matthewrylander/ECE445WasteBinMonitor/Notebooks/Matthew Rylander - mjr7/Pictures/IMG_6164.jpg

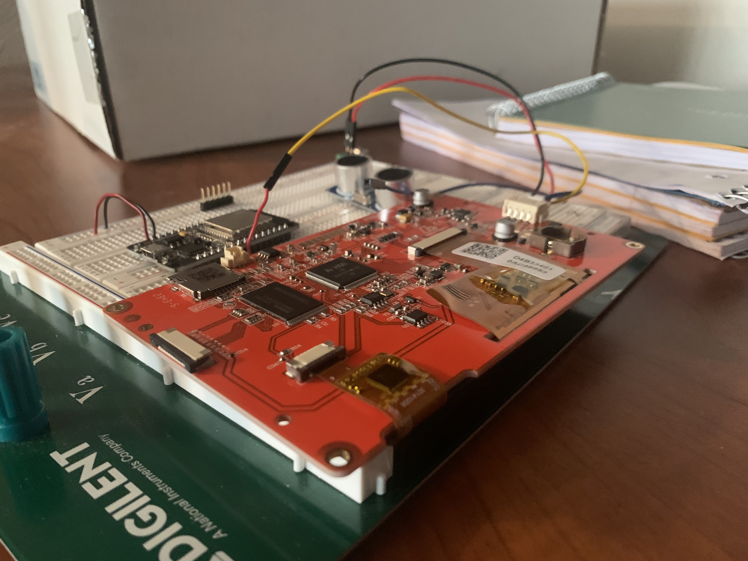
Notebooks/Matthew Rylander - mjr7/Pictures/IMG_6164.jpg
