matthewrylander/ECE445WasteBinMonitor/Notebooks/Matthew Rylander - mjr7/Pictures/IMG_6198.jpg

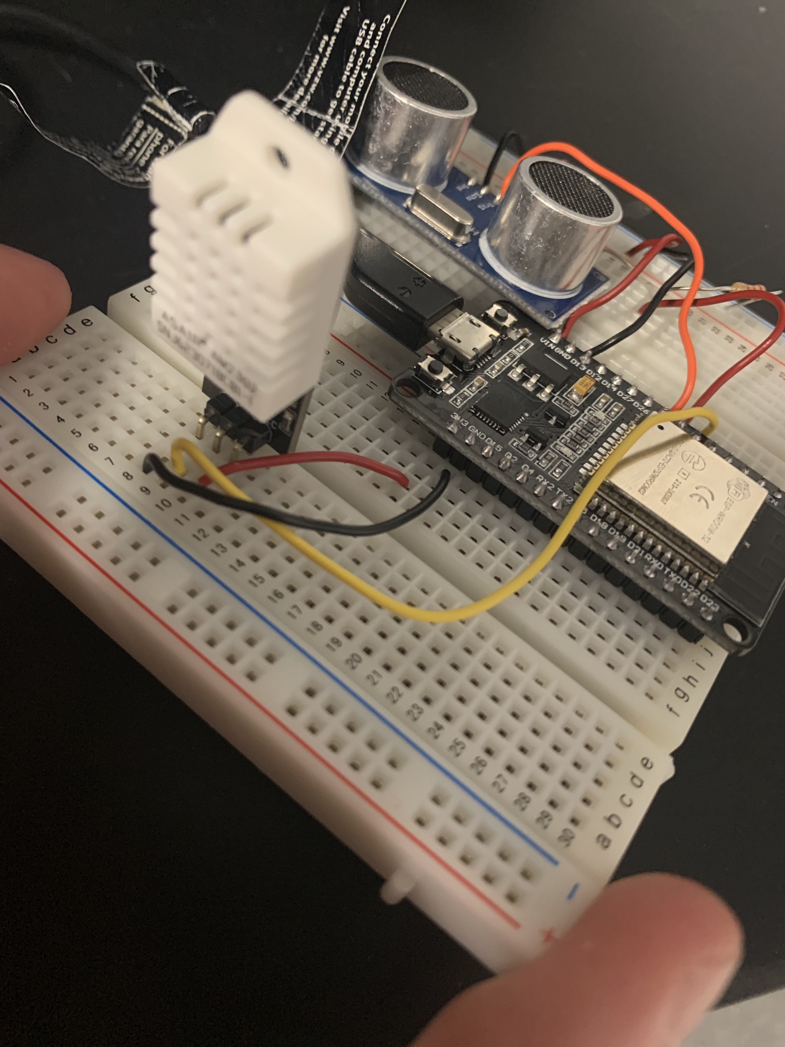
Notebooks/Matthew Rylander - mjr7/Pictures/IMG_6198.jpg
