matthewrylander/ECE445WasteBinMonitor/Notebooks/Matthew Rylander - mjr7/Pictures/IMG_6201.jpg

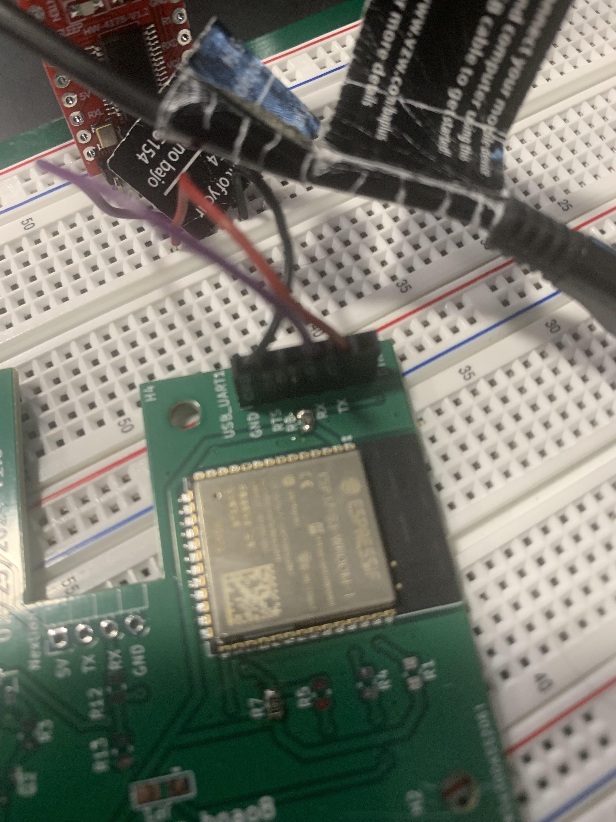
Notebooks/Matthew Rylander - mjr7/Pictures/IMG_6201.jpg
