matthewrylander/ECE445WasteBinMonitor/Notebooks/Matthew Rylander - mjr7/Pictures/IMG_6240.JPG

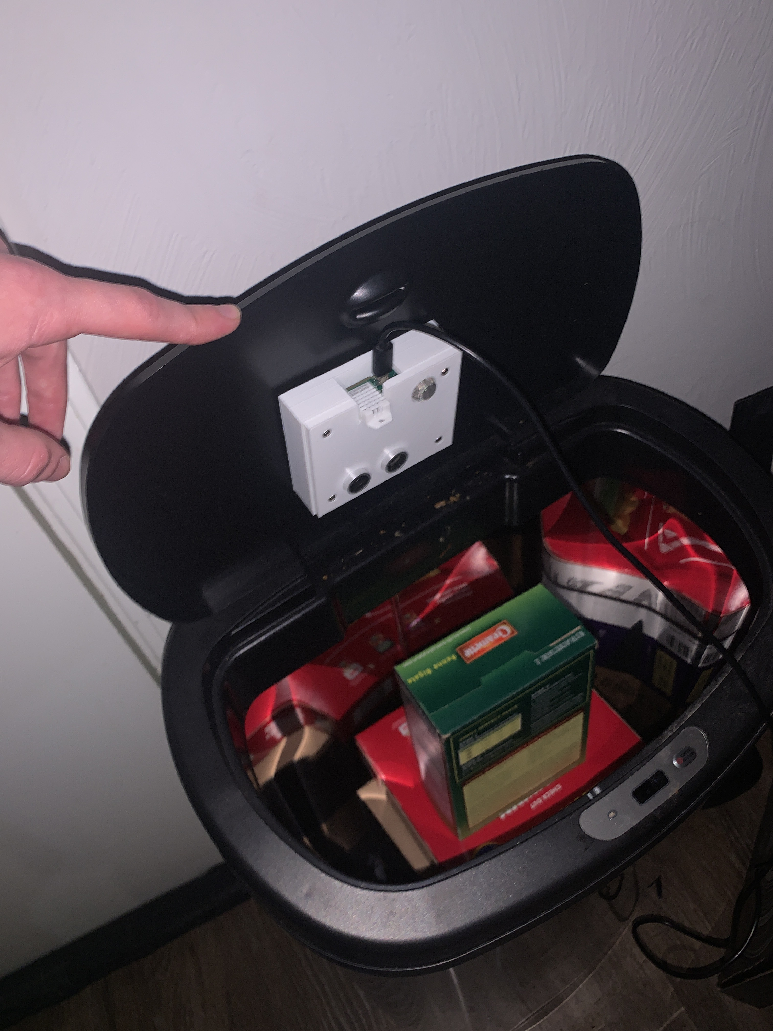
Notebooks/Matthew Rylander - mjr7/Pictures/IMG_6240.JPG
