matthewrylander/ECE445WasteBinMonitor/Notebooks/Matthew Rylander - mjr7/Pictures/Screen_software_UI.jpg

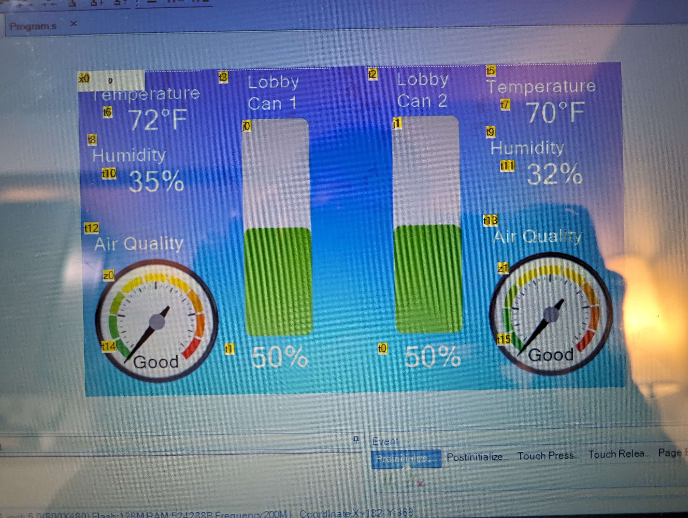
Notebooks/Matthew Rylander - mjr7/Pictures/Screen_software_UI.jpg
