matthewrylander/ECE445WasteBinMonitor/Notebooks/Matthew Rylander - mjr7/Pictures/Sensor_mounted.jpg

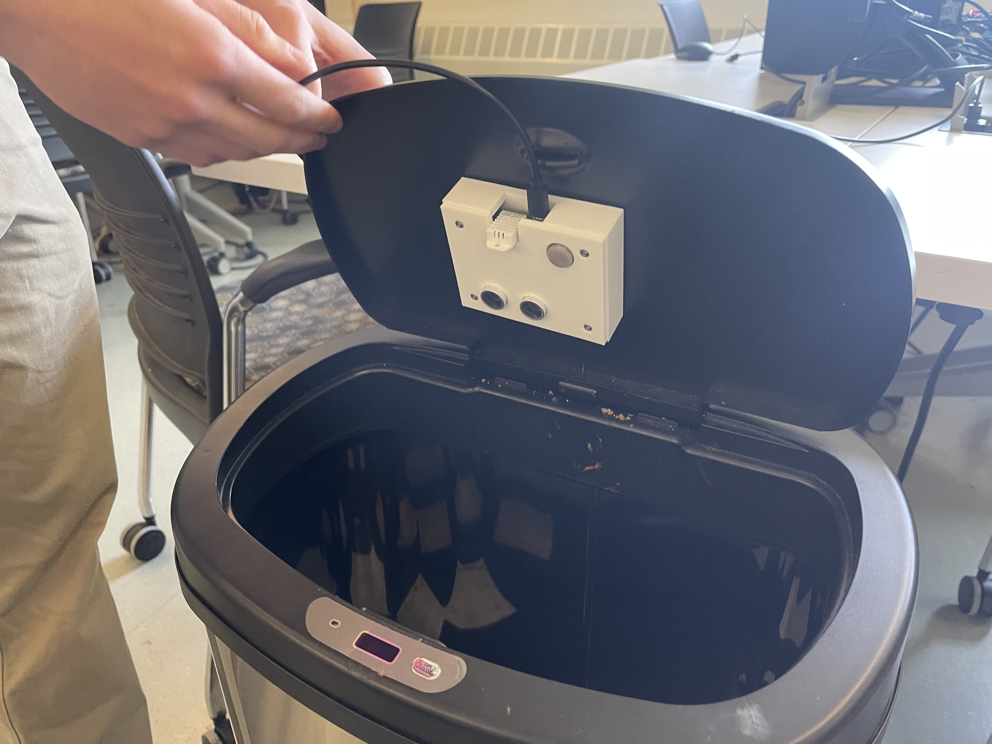
Notebooks/Matthew Rylander - mjr7/Pictures/Sensor_mounted.jpg
