matthewrylander/ECE445WasteBinMonitor/Hub Board/ESP32.kicad_pcb

## KiCad design Hub Board/ESP32.kicad_pcb (2024-03-01, an earlier design)

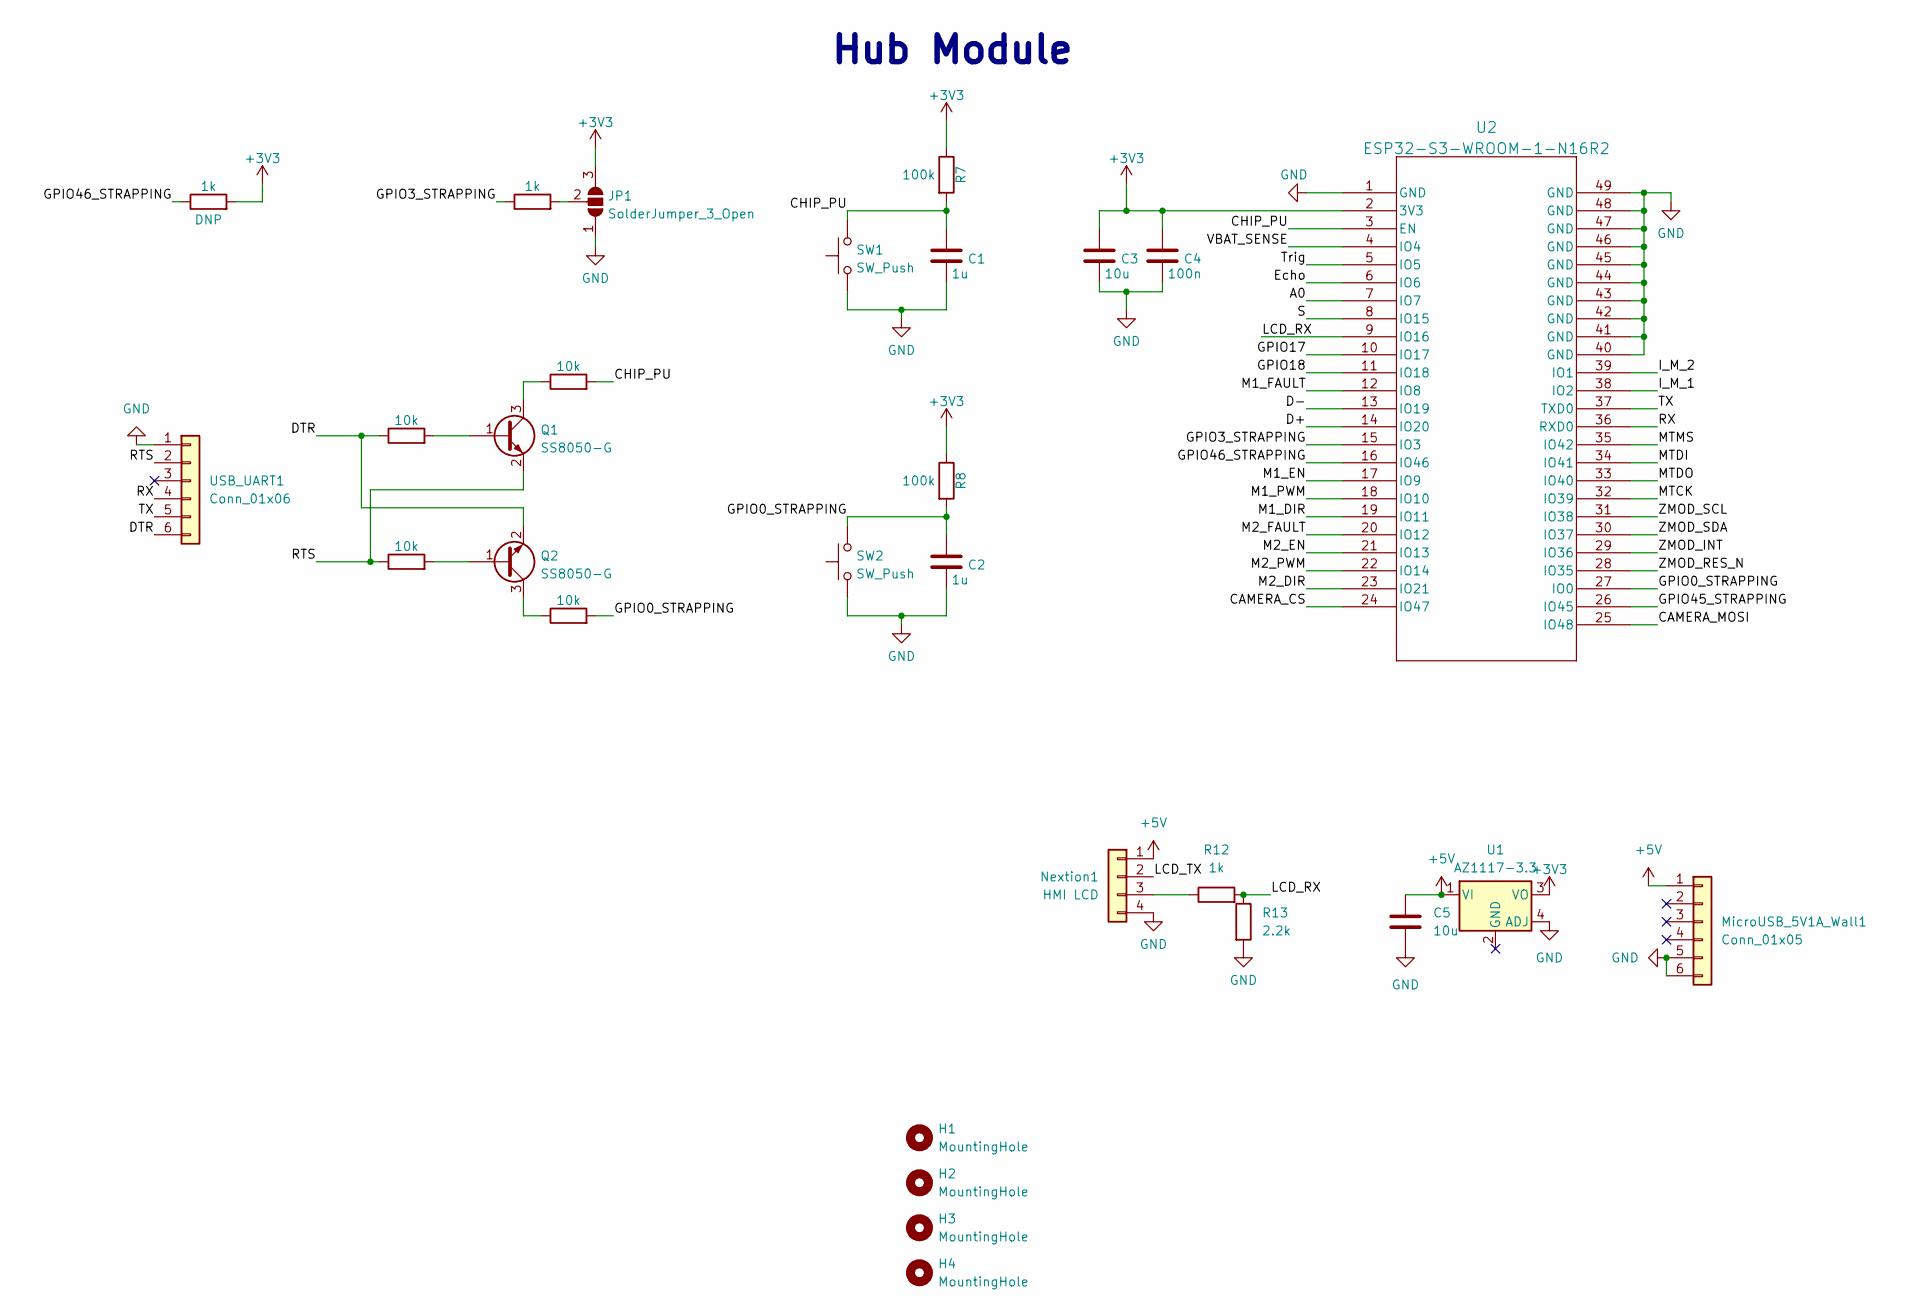
[picture p32: schematic ESP32.kicad_sch]

Parts:
C1, C2: 1u; C_0805_2012Metric
C3, C5: 10u; C_0805_2012Metric
C4: 100n; C_0805_2012Metric
H1, H2, H3, H4: MountingHole; MountingHole_3.2mm_M3
JP1: SolderJumper_3_Open; SolderJumper-3_P2.0mm_Open_TrianglePad1.0x1.5mm
MicroUSB_5V1A_Wall1: Conn_01x05; USB_Micro-B_Amphenol_10104110_Horizontal
Nextion1: HMI LCD; PinHeader_1x04_P2.54mm_Horizontal
Q1, Q2: SS8050-G; SOT-23
R1, R4, R12: 1k; R_0805_2012Metric
R2, R3, R5, R6: 10k; R_0805_2012Metric
R7, R8: 100k; R_0805_2012Metric
R13: 2.2k; R_0805_2012Metric
SW1, SW2: SW_Push; SW_PUSH_6mm
U1: AZ1117-3.3; AZ1117C-SOT223
U2: ESP32-S3-WROOM-1-N16R2; ESP32-S3-WROOM-1_EXP
USB_UART1: Conn_01x06; PinHeader_1x06_P2.54mm_Horizontal

Connections:
+3V3: C3.1, C4.1, JP1.3 (B), R1.2, R7.1, R8.1, U1.3 (VO), U2.2 (3V3)
+5V: C5.1, MicroUSB_5V1A_Wall1.1, Nextion1.1, U1.1 (VI)
/A0: U2.7 (IO7)
/CAMERA_CS: U2.24 (IO47)
/CAMERA_MOSI: U2.25 (IO48)
/CHIP_PU: C1.1, R5.2, R7.2, SW1.2, U2.3 (EN)
/D+: U2.14 (IO20)
/D-: U2.13 (IO19)
/DTR: Q2.2 (E), R2.1, USB_UART1.6
/Echo: U2.6 (IO6)
/GPIO0_STRAPPING: C2.1, R6.2, R8.2, SW2.2, U2.27 (IO0)
/GPIO3_STRAPPING: R4.1, U2.15 (IO3)
/GPIO17: U2.10 (IO17)
/GPIO18: U2.11 (IO18)
/GPIO45_STRAPPING: U2.26 (IO45)
/GPIO46_STRAPPING: R1.1, U2.16 (IO46)
/I_M_1: U2.38 (IO2)
/I_M_2: U2.39 (IO1)
/LCD_RX: R12.2, R13.1, U2.9 (IO16)
/LCD_TX: Nextion1.2
/M1_DIR: U2.19 (IO11)
/M1_EN: U2.17 (IO9)
/M1_FAULT: U2.12 (IO8)
/M1_PWM: U2.18 (IO10)
/M2_DIR: U2.23 (IO21)
/M2_EN: U2.21 (IO13)
/M2_FAULT: U2.20 (IO12)
/M2_PWM: U2.22 (IO14)
/MTCK: U2.32 (IO39)
/MTDI: U2.34 (IO41)
/MTDO: U2.33 (IO40)
/MTMS: U2.35 (IO42)
/RTS: Q1.2 (E), R3.1, USB_UART1.2
/RX: U2.36 (RXD0), USB_UART1.4
/S: U2.8 (IO15)
/TX: U2.37 (TXD0), USB_UART1.5
/Trig: U2.5 (IO5)
/VBAT_SENSE: U2.4 (IO4)
/ZMOD_INT: U2.29 (IO36)
/ZMOD_RES_N: U2.28 (IO35)
/ZMOD_SCL: U2.31 (IO38)
/ZMOD_SDA: U2.30 (IO37)
GND: C1.2, C2.2, C3.2, C4.2, C5.2, JP1.1 (A), MicroUSB_5V1A_Wall1.5, MicroUSB_5V1A_Wall1.6, Nextion1.4, R13.2, SW1.1, SW2.1, U1.4 (ADJ), U2.1 (GND), U2.40 (GND), U2.41 (GND), U2.42 (GND), U2.43 (GND), U2.44 (GND), U2.45 (GND), U2.46 (GND), U2.47 (GND), U2.48 (GND), U2.49 (GND), USB_UART1.1
unnamed: JP1.2 (C), R4.2
unnamed: Nextion1.3, R12.1
unnamed: Q1.1 (B), R2.2
unnamed: Q1.3 (C), R5.1
unnamed: Q2.1 (B), R3.2
unnamed: Q2.3 (C), R6.1

Notes on the sheet:
Hub Module

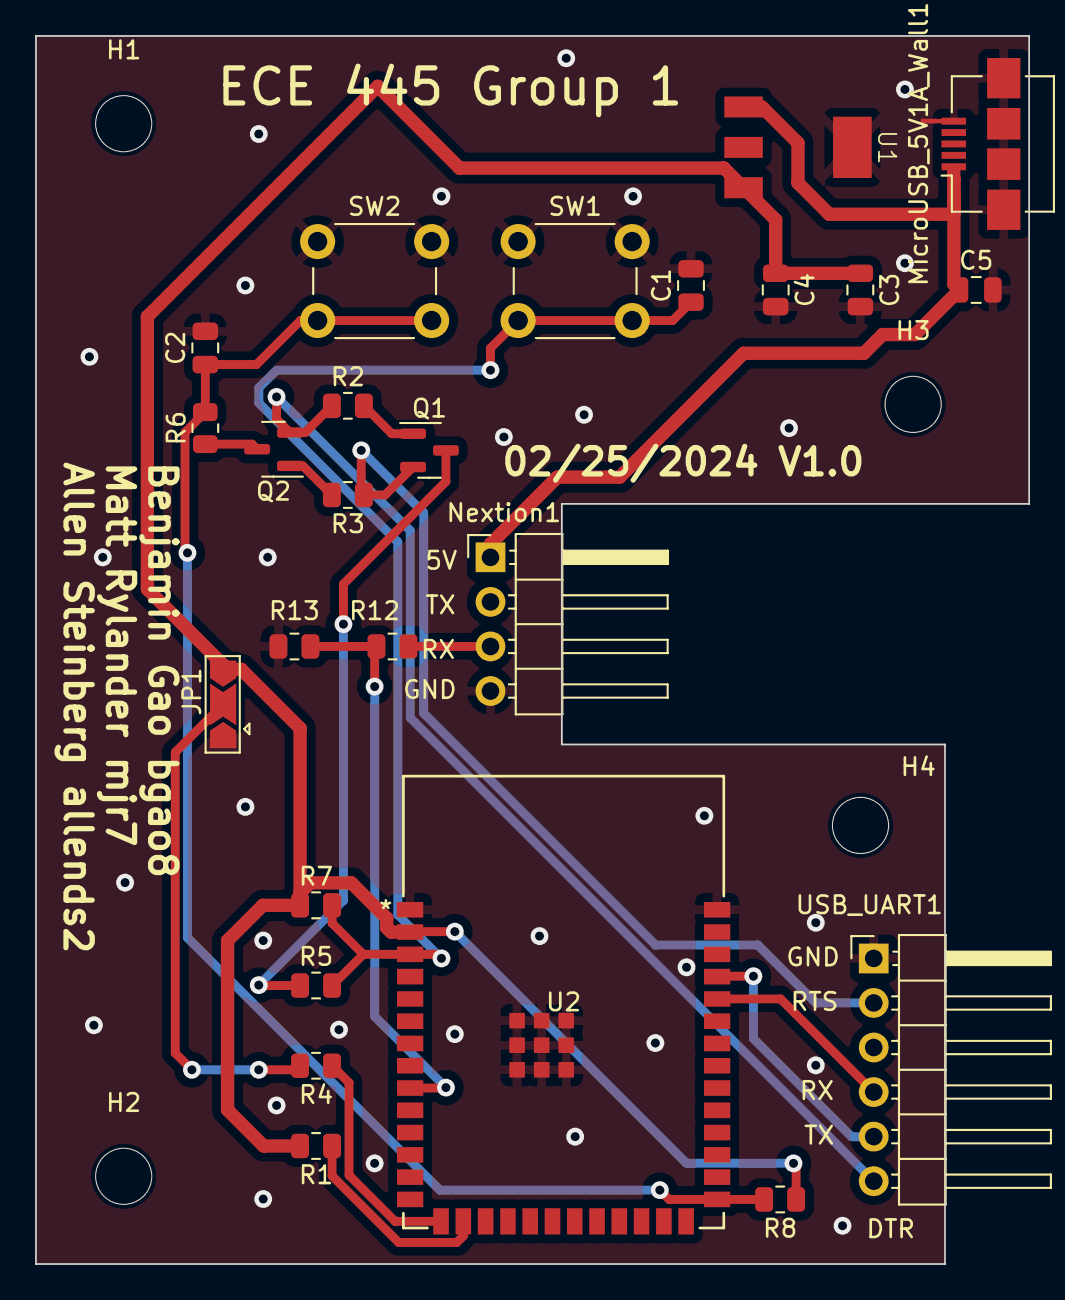
[picture p33: board Hub Board/ESP32.kicad_pcb from above]

Board: 2 copper layers, 56.6 x 70.0 mm, 29 parts (0 on the bottom side), 18 nets.
