matthewrylander/ECE445WasteBinMonitor/(commit log)

2024-02-20 Upload schematic
    Schematic without levelshifter and needing changes
    [ESP32.kicad_pcb, ESP32.kicad_sch]
2024-02-20 Update Schematic
    [ESP32.kicad_sch]
2024-02-20 Schematic Updates
    [ESP32.kicad_pcb, ESP32.kicad_sch]
2024-02-20 Added voltage regulators to both schematics
    [ESP32.kicad_sch]
2024-02-21 Added PCB for sensor board
    Does not include screw holes. Ignored 4 warnings (silkscreen off board, silkscreen overlap in esp32 which was part of orig footprint, and 2 instances of the solder mask being insufficient on solder bridge, intentional)
    [ESP32.kicad_pcb, ESP32.kicad_sch]
2024-02-29 Add hub board v1.0 and Sensor Board v2.0
    [ESP32-B_Cu.gbr, ESP32-B_Mask.gbr, ESP32-B_Paste.gbr, ESP32-B_Silkscreen.gbr, ESP32-Edge_Cuts.gbr, ESP32-F_Cu.gbr, ESP32-F_Mask.gbr, ESP32-F_Paste.gbr]
2024-02-29 Added I2C resistors
    [ESP32.kicad_sch]
2024-03-26 Uploaded version 2 of sensor board schematic, still needs PCB layout
    [ESP32-B_Cu.gbr, ESP32-B_Mask.gbr, ESP32-B_Paste.gbr, ESP32-B_Silkscreen.gbr, ESP32-Edge_Cuts.gbr, ESP32-F_Cu.gbr, ESP32-F_Mask.gbr, ESP32-F_Paste.gbr]
2024-03-26 Add final sensor board
    [ESP32-B_Cu.gbr, ESP32-B_Mask.gbr, ESP32-B_Paste.gbr, ESP32-B_Silkscreen.gbr, ESP32-Edge_Cuts.gbr, ESP32-F_Cu.gbr, ESP32-F_Mask.gbr, ESP32-F_Paste.gbr]
2024-05-02 Cleaned up files
    [ESP32-B_Cu.gbr, ESP32-B_Mask.gbr, ESP32-B_Paste.gbr, ESP32-B_Silkscreen.gbr, ESP32-Edge_Cuts.gbr, ESP32-F_Cu.gbr, ESP32-F_Mask.gbr, ESP32-F_Paste.gbr]
