matthewrylander/ECE445WasteBinMonitor/Notebooks/Matthew Rylander - mjr7/Pictures/IMG_6166.JPG

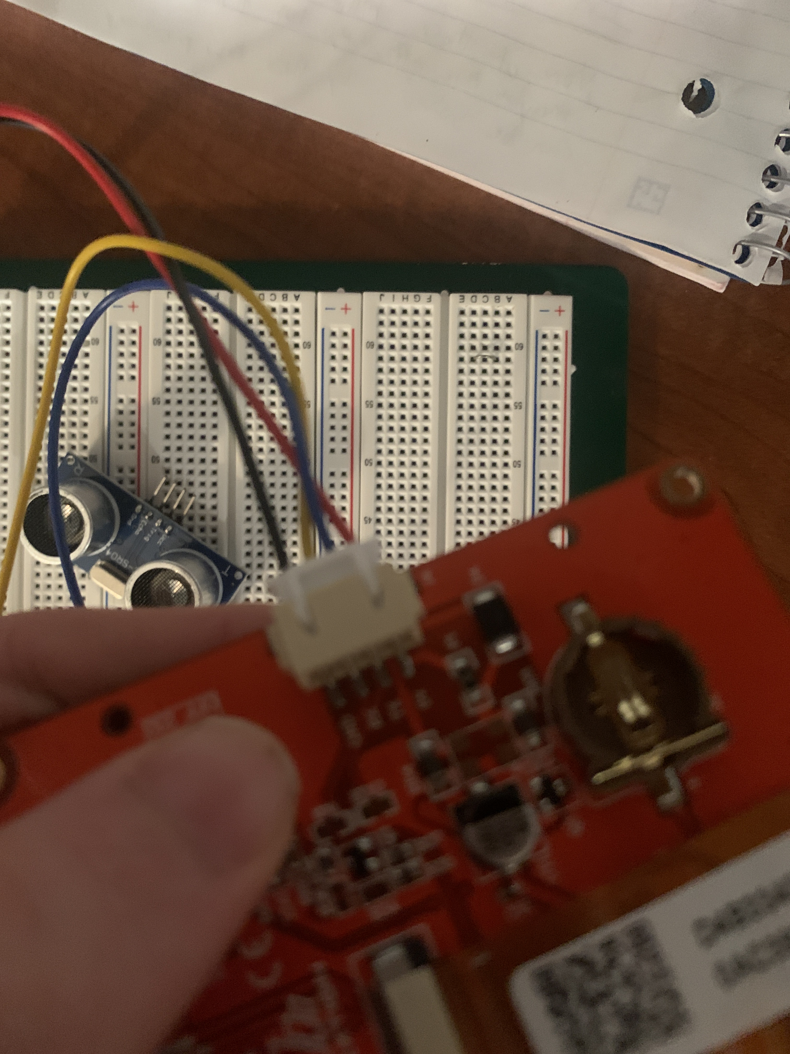
Notebooks/Matthew Rylander - mjr7/Pictures/IMG_6166.JPG
