matthewrylander/ECE445WasteBinMonitor/Notebooks/Matthew Rylander - mjr7/Pictures/IMG_6196.jpg

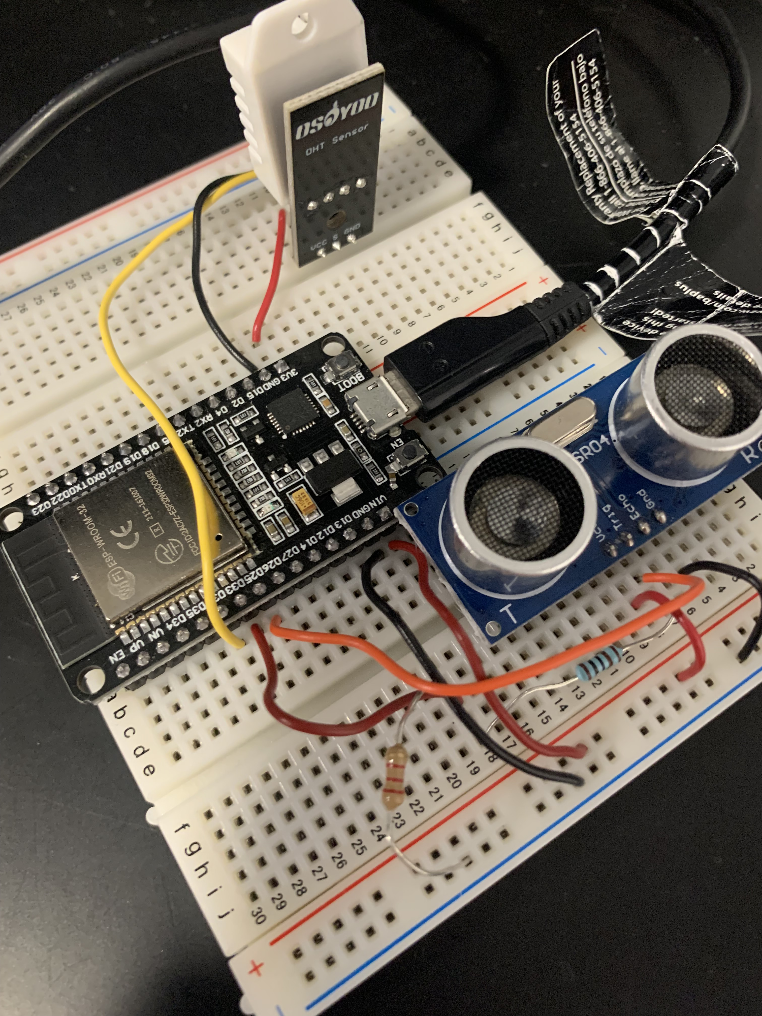
Notebooks/Matthew Rylander - mjr7/Pictures/IMG_6196.jpg
